SensorsforRestoration/SensorsForRestoration/updates/week5/forces.pdf

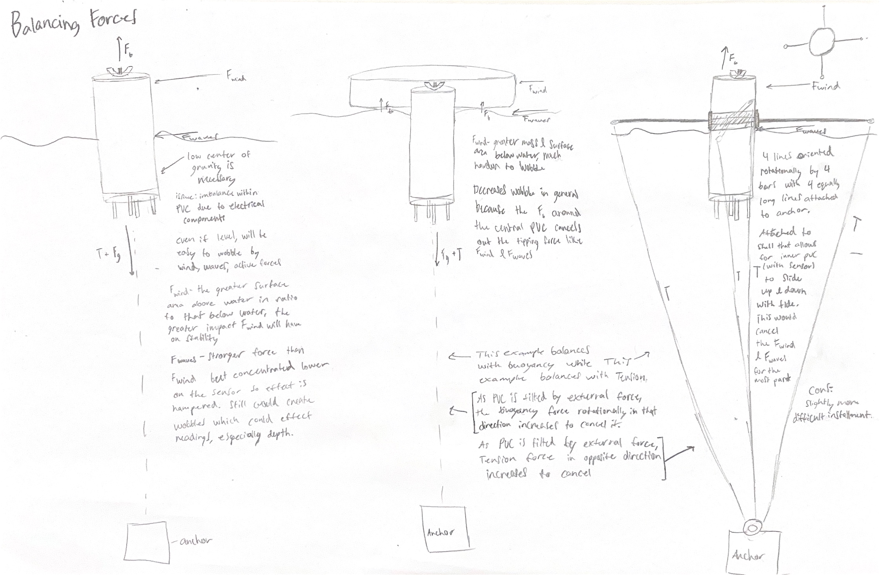
[picture p1: page 1]
