SensorsforRestoration/SensorsForRestoration/docs/tools/image2.png

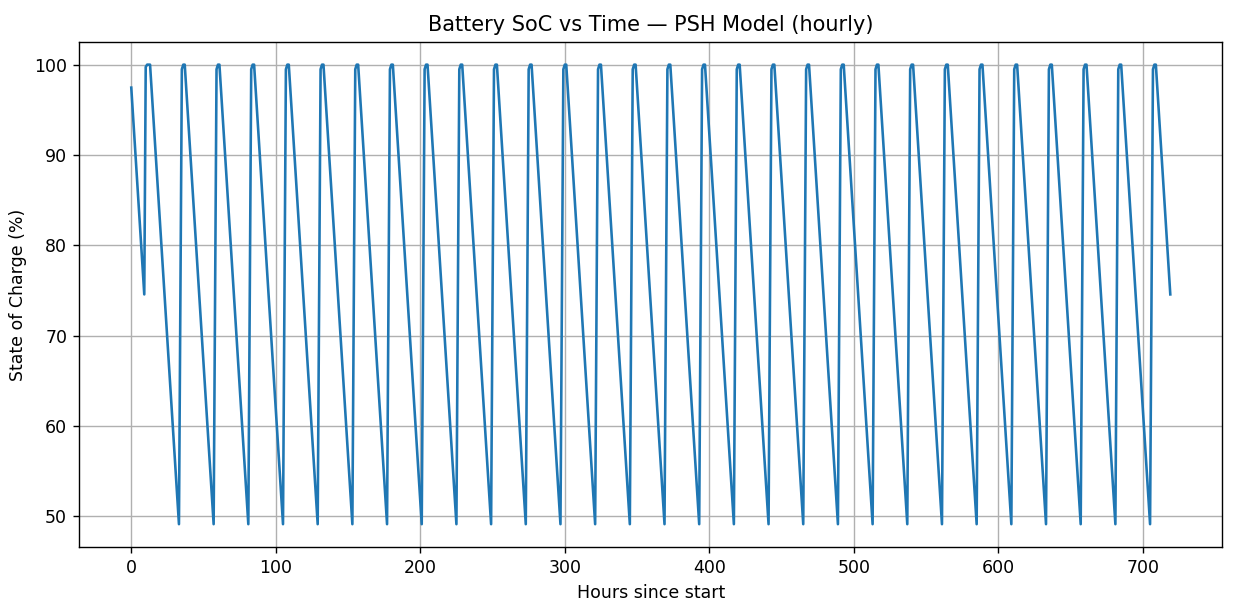
docs/tools/image2.png
