SensorsforRestoration/SensorsForRestoration/updates/week5/depth2.png

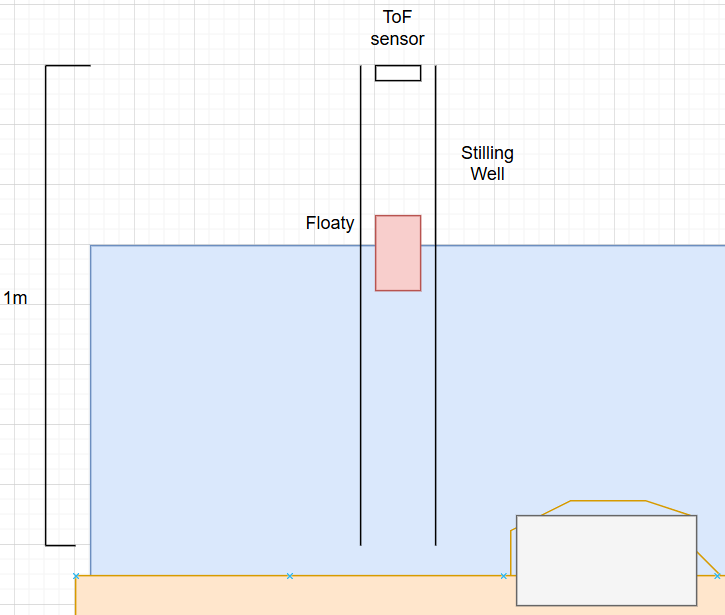
updates/week5/depth2.png
