SensorsforRestoration/SensorsForRestoration/updates/week5/explored_depth.png

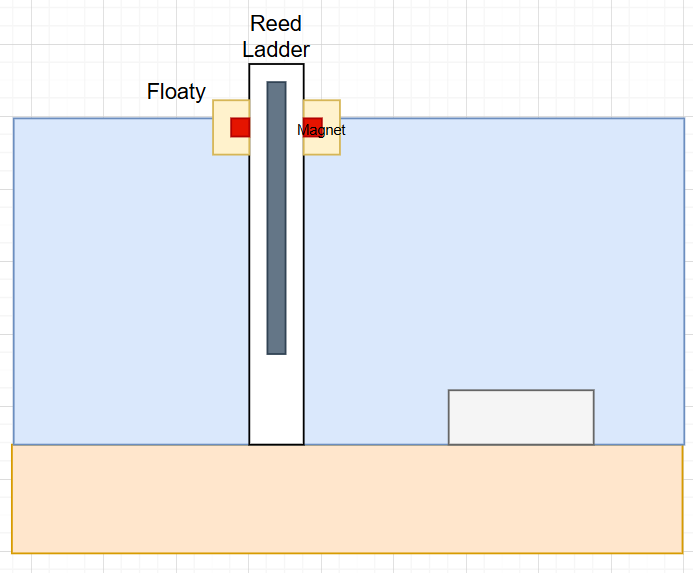
updates/week5/explored_depth.png
