SensorsforRestoration/SensorsForRestoration/updates/week6/friedSensor.jpeg

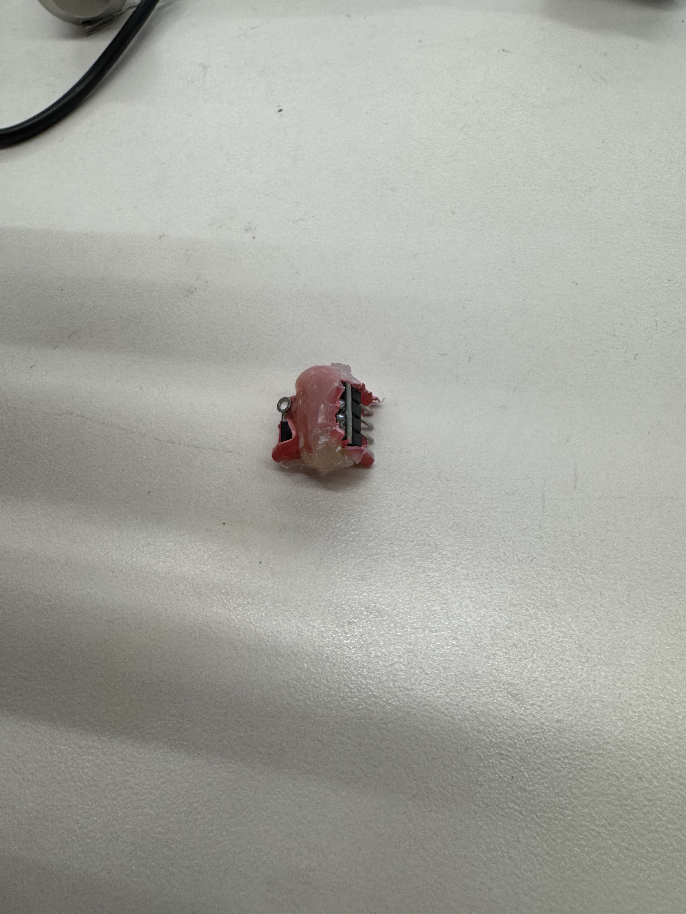
updates/week6/friedSensor.jpeg
