SensorsforRestoration/SensorsForRestoration/updates/week6/SubmergenceDepth.jpg

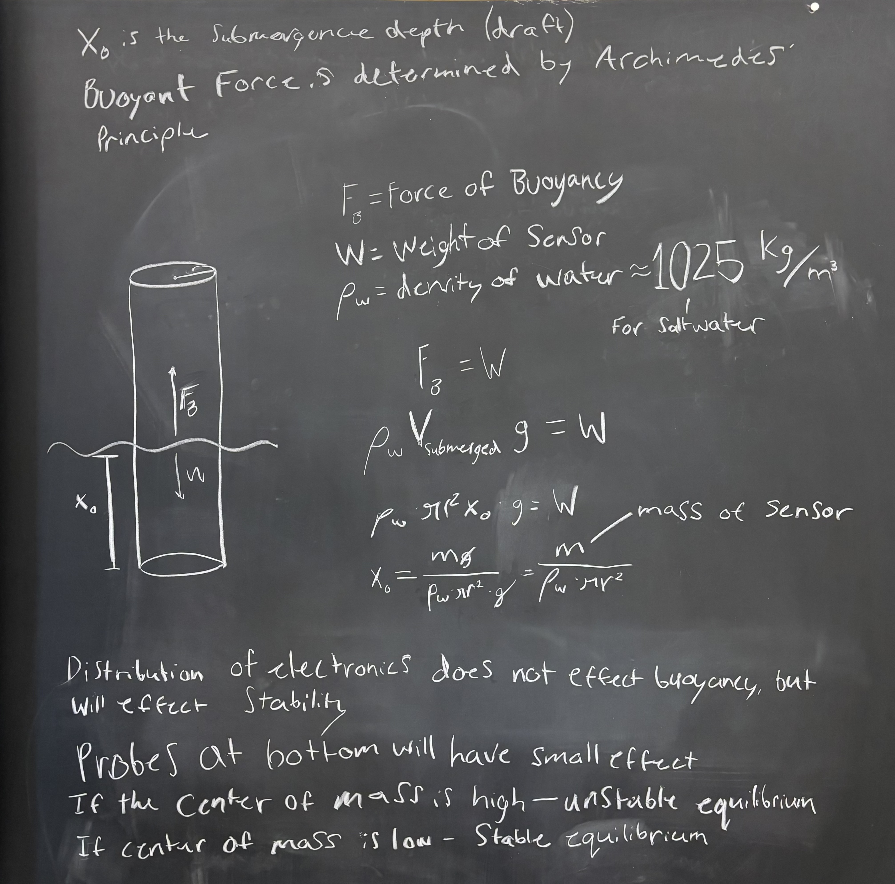
updates/week6/SubmergenceDepth.jpg
