SensorsforRestoration/SensorsForRestoration/updates/week7/Depth_with_biofowling.jpg

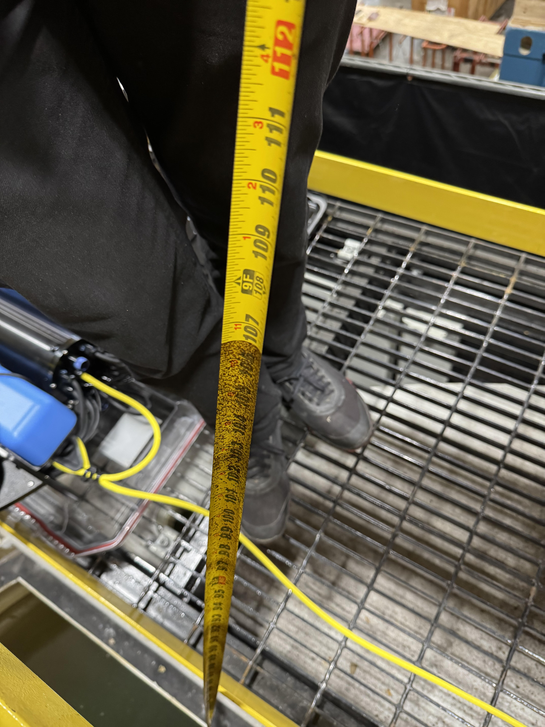
updates/week7/Depth_with_biofowling.jpg
