SensorsforRestoration/SensorsForRestoration/updates/week7/Fun_photo.jpg

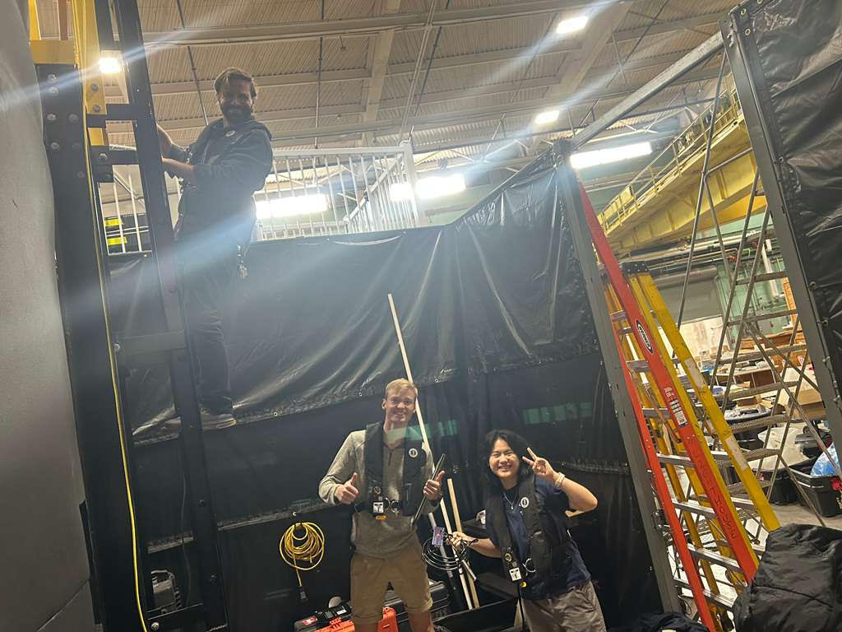
updates/week7/Fun_photo.jpg
