SensorsforRestoration/SensorsForRestoration/updates/week7/Graph1.png

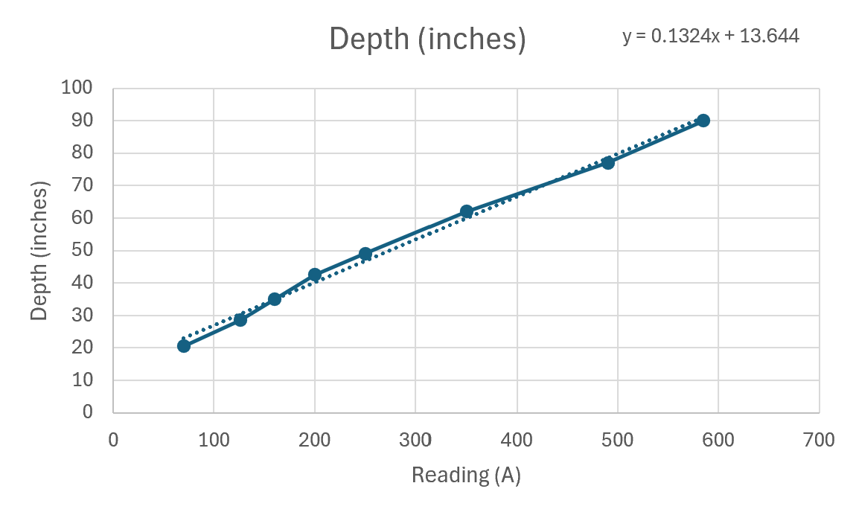
updates/week7/Graph1.png
