SensorsforRestoration/SensorsForRestoration/updates/week7/IMG_4251.jpg

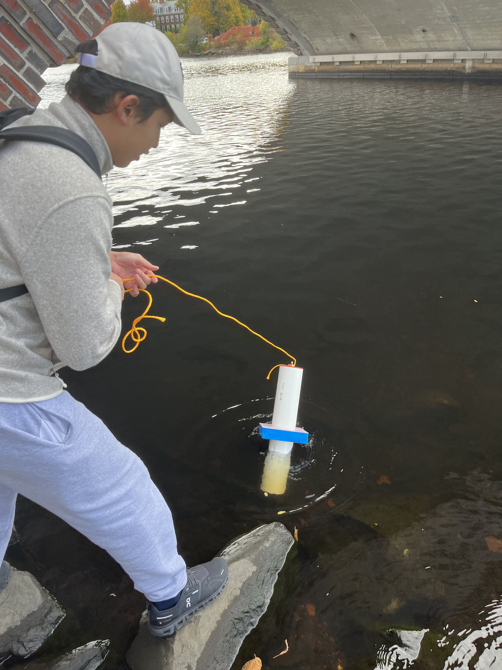
updates/week7/IMG_4251.jpg
