SensorsforRestoration/SensorsForRestoration/updates/week8/ColourCord.jpg

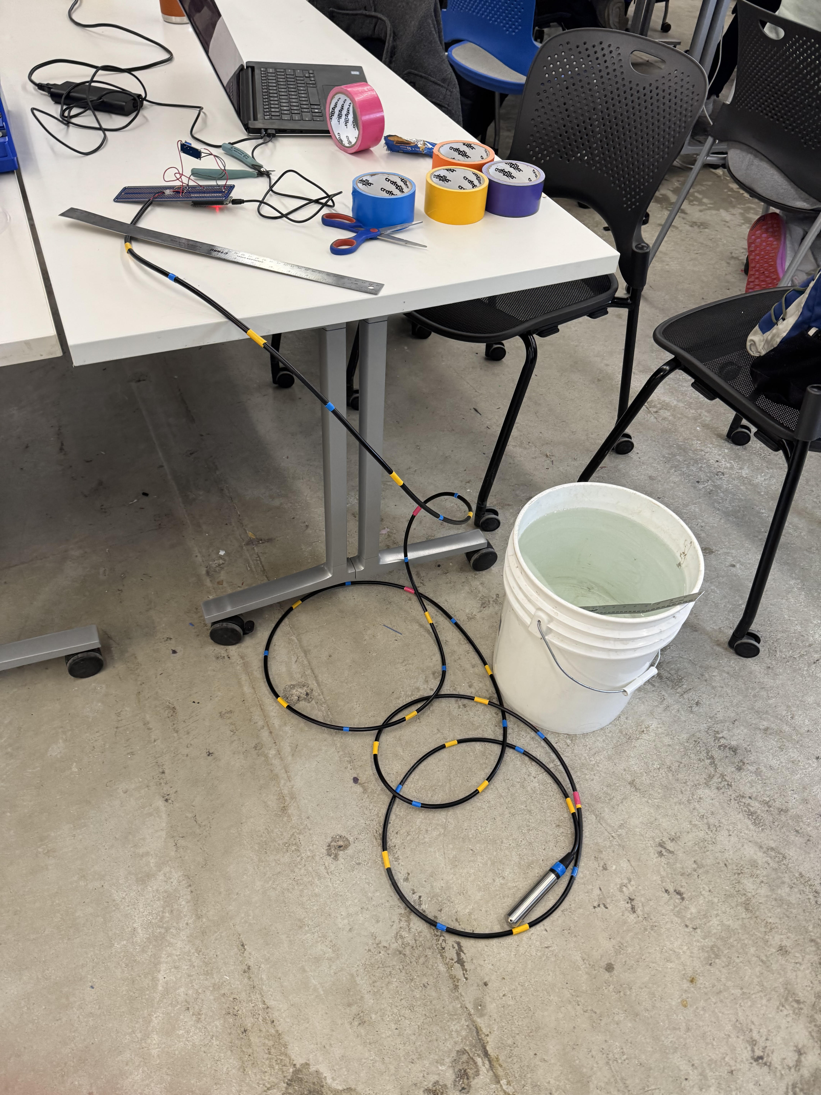
updates/week8/ColourCord.jpg
