SensorsforRestoration/SensorsForRestoration/updates/week8/Graph2.png

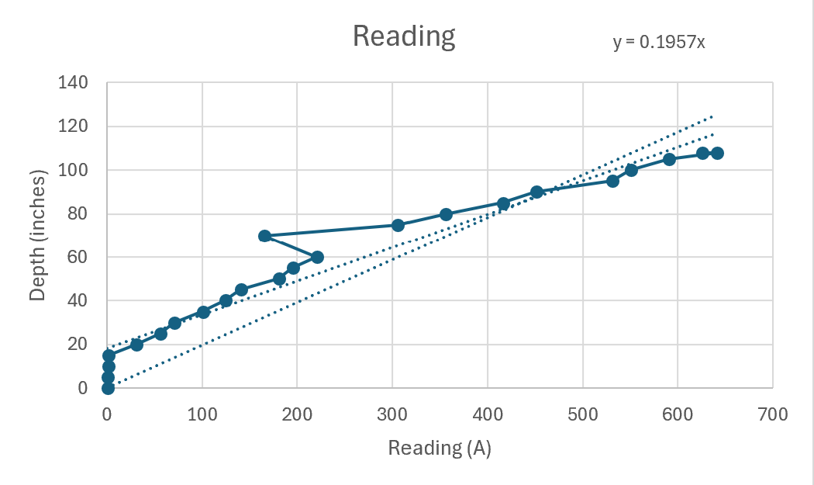
updates/week8/Graph2.png
