SensorsforRestoration/SensorsForRestoration/updates/week8/Table2.png

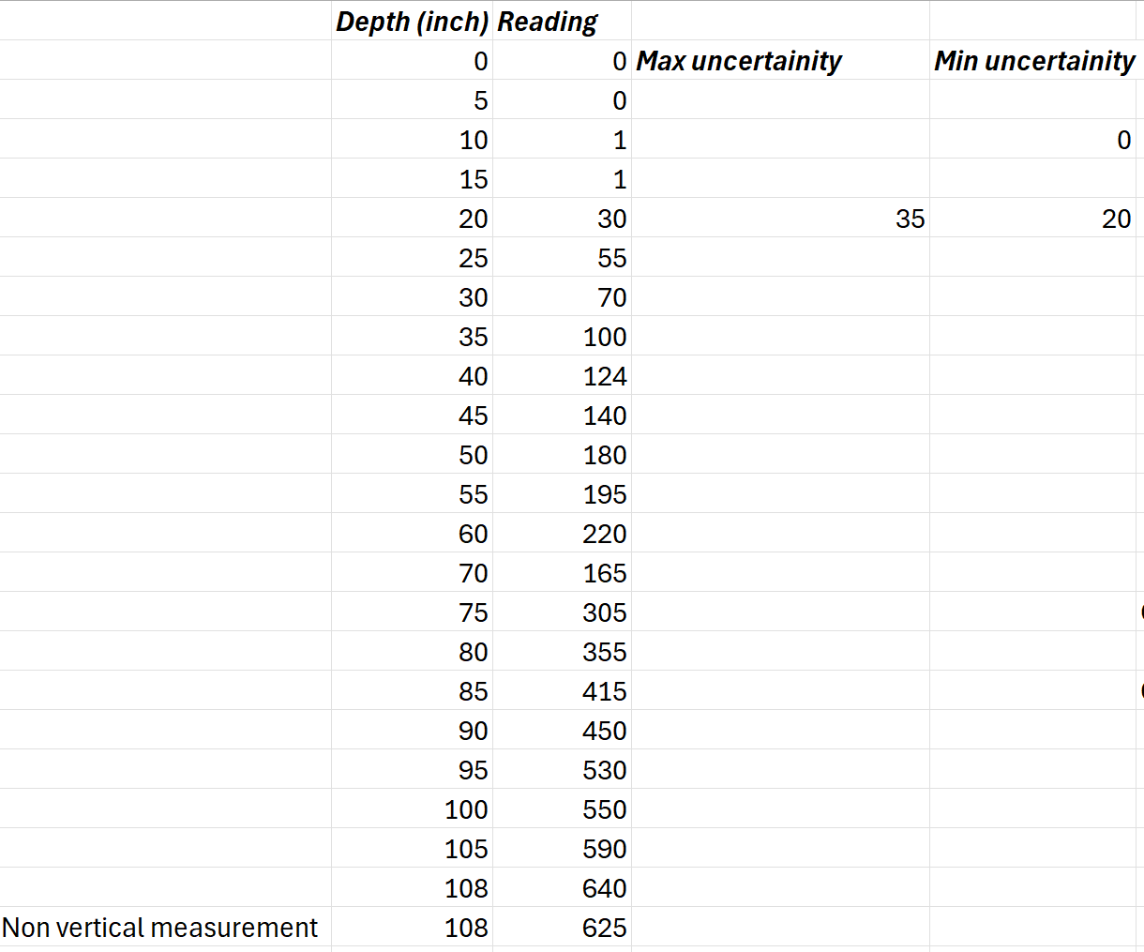
updates/week8/Table2.png
