SensorsforRestoration/SensorsForRestoration/updates/week9/Cad_picture2.png

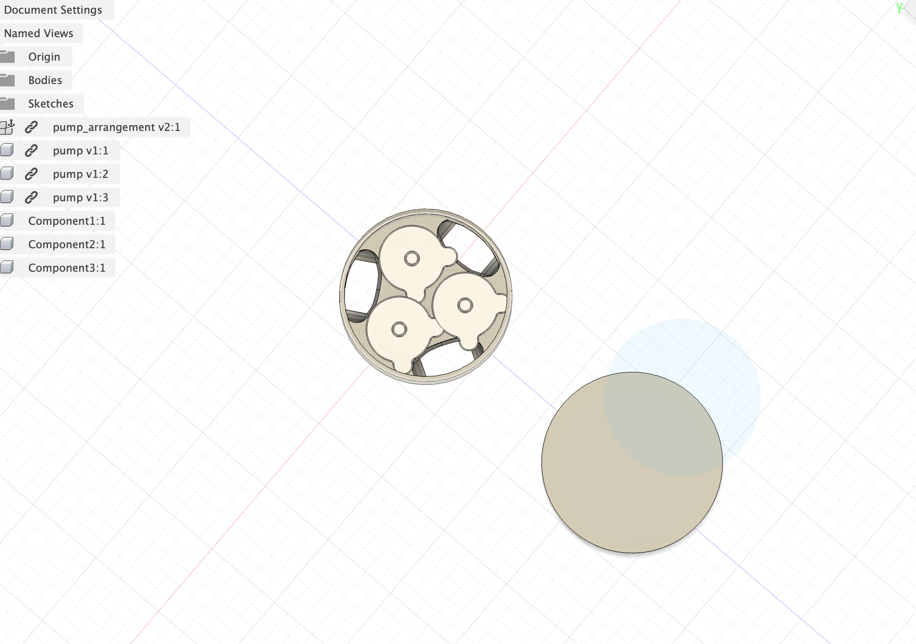
updates/week9/Cad_picture2.png
