SensorsforRestoration/SensorsForRestoration/updates/week9/Cad_picture.png

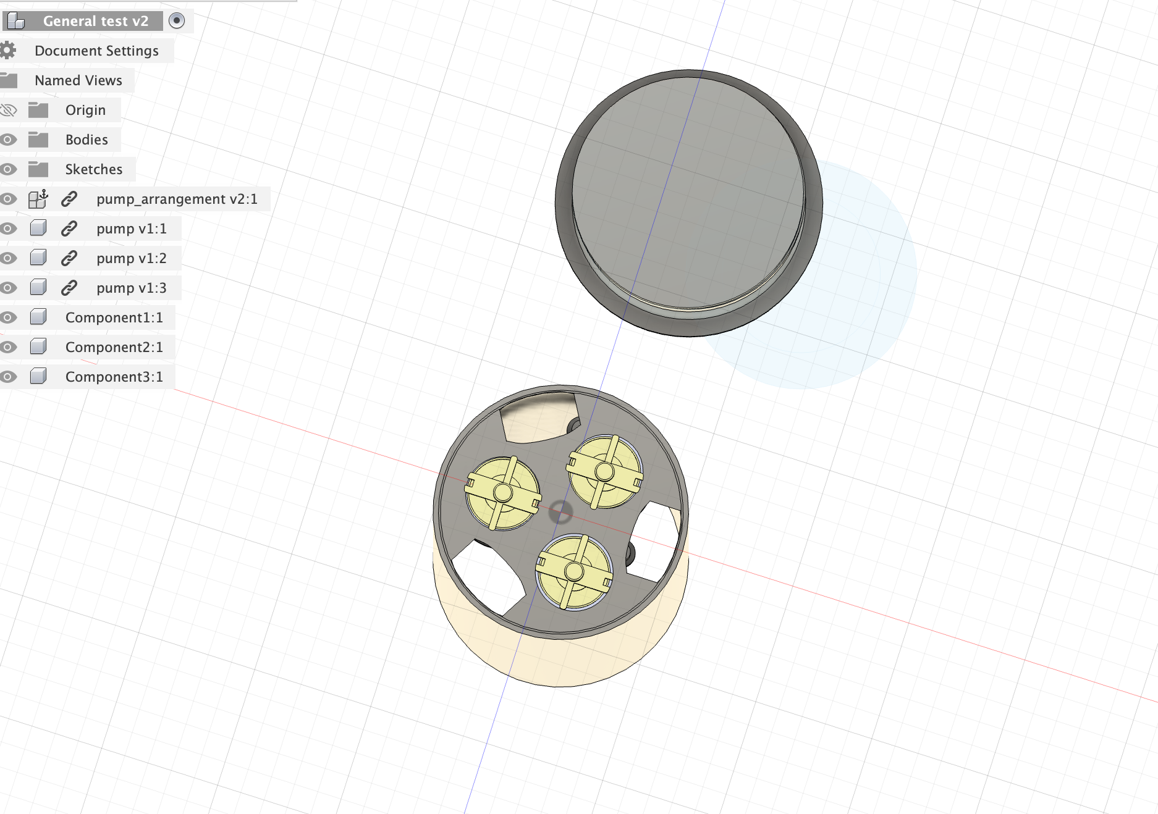
updates/week9/Cad_picture.png
