SensorsforRestoration/SensorsForRestoration/updates/week10/image2.png

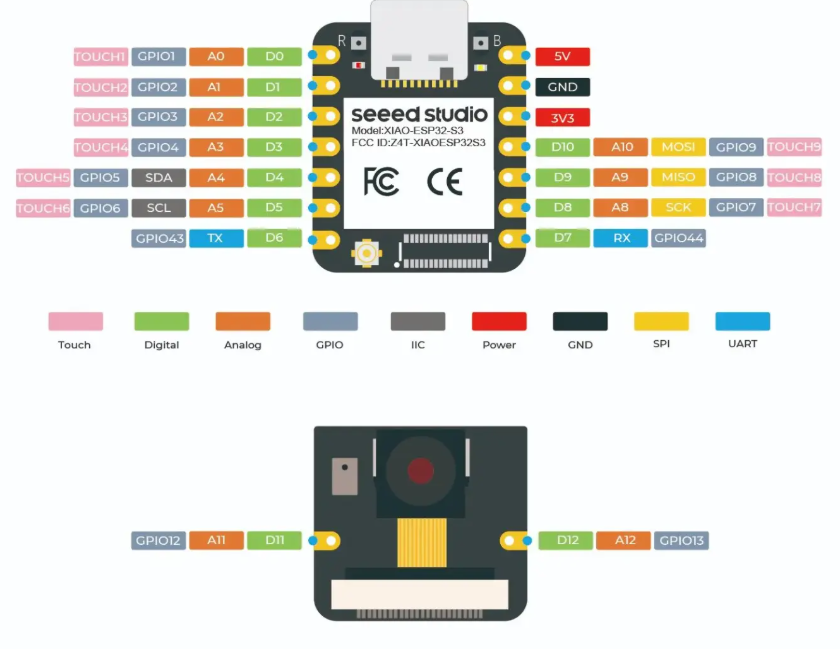
updates/week10/image2.png
