SensorsforRestoration/SensorsForRestoration/updates/week10/image.png

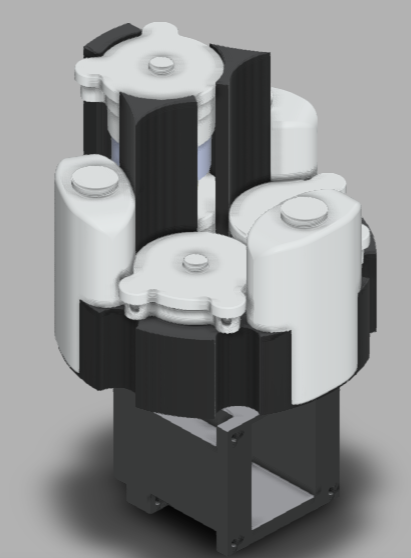
updates/week10/image.png
