SensorsforRestoration/SensorsForRestoration/updates/week10/IMG_4394.jpg

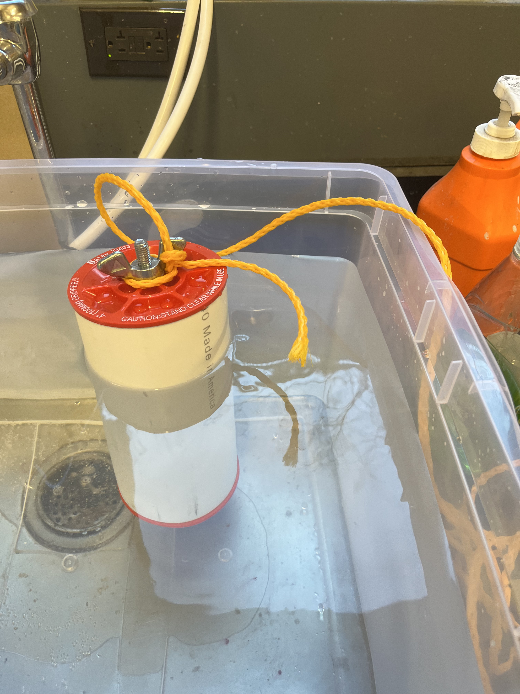
updates/week10/IMG_4394.jpg
