SensorsforRestoration/SensorsForRestoration/docs/build_instruction/BOM.md

(#) Bill of Materials (BOM)

Estimated prices and weights for the core parts used in the project. Prices are approximate (USD) and weights are in grams (g). Totals are rounded.

| Item | Qty | Unit price (USD) | Unit weight (g) | Ext. price (USD) | Ext. weight (g) |
|---|---:|---:|---:|---:|---:|
| 18650 Li-ion cell (protected/typical) | 1 | 6.00 | 48 | 6.00 | 48 |
| 18650 holder / protection (holder or small PCB) | 1 | 2.00 | 12 | 2.00 | 12 |
| Small DC / peristaltic pump (micro) | 4 | 6.50 | 70 | 26.00 | 280 |
| L9110 dual motor driver board | 2 | 2.00 | 15 | 4.00 | 30 |
| Seeed XIAO ESP32‑S3 Sense | 1 | 12.00 | 6 | 12.00 | 6 |
| Depth sensor (waterproof ultrasonic / JSN‑SR04T or similar) | 1 | 8.00 | 20 | 8.00 | 20 |
| Salinity sensor (analog conductivity probe + module) | 1 | 12.00 | 30 | 12.00 | 30 |
| Reactant A (reagent bottle) | 1 | 5.00 | 50 | 5.00 | 50 |
| Reactant B (reagent bottle) | 1 | 5.00 | 50 | 5.00 | 50 |
| Reactant C (reagent bottle) | 1 | 5.00 | 50 | 5.00 | 50 |
| Miscellaneous (wiring, connectors, screws, enclosure bits) | 1 | 10.00 | 80 | 10.00 | 80 |

| 4" PVC pipe (~35 cm length) | 1 | 6.00 | 500 | 6.00 | 500 |

| **Totals** |  |  |  | **101.00 USD** | **1,156 g** |

Notes

- Prices are ballpark estimates (consumer hobbyist retail) as of 2025‑11‑18 and will vary by supplier, quantity, shipping and taxes.
- Weights are approximate based on typical small parts; they exclude packaging and any large enclosures or extra batteries.
- Vendor‑linked BOM (Mouser/AliExpress/Adafruit) work in progress
