SensorsforRestoration/SensorsForRestoration/build/index.html

# Build

### Contents

© Sensors for Restoration
