SensorsforRestoration/SensorsForRestoration/updates/week5/20251410Test001.jpg

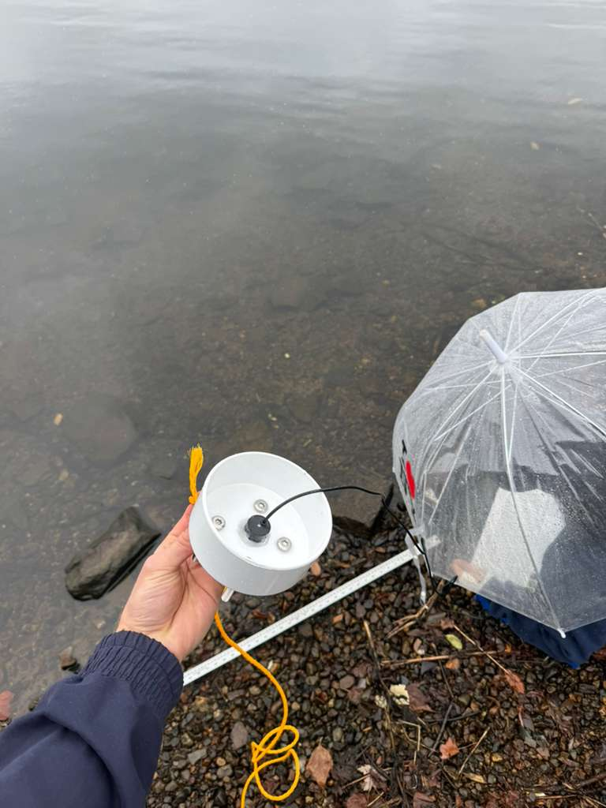
updates/week5/20251410Test001.jpg
