SensorsforRestoration/SensorsForRestoration/updates/week5/20251410Test002.jpg

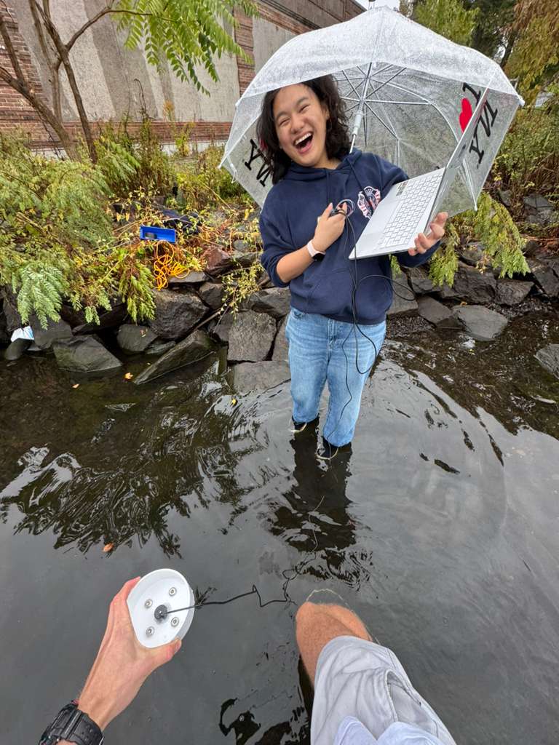
updates/week5/20251410Test002.jpg
