SensorsforRestoration/SensorsForRestoration/updates/week5/20251410Test003.jpg

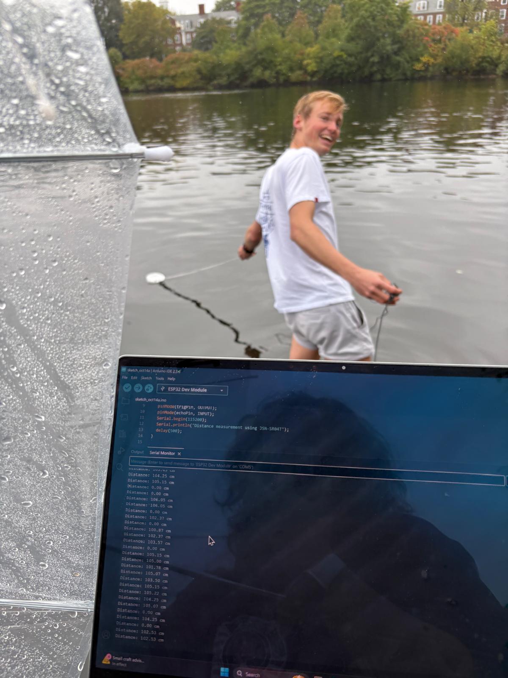
updates/week5/20251410Test003.jpg
