SensorsforRestoration/SensorsForRestoration/updates/week5/Nitrate_Test.jpg

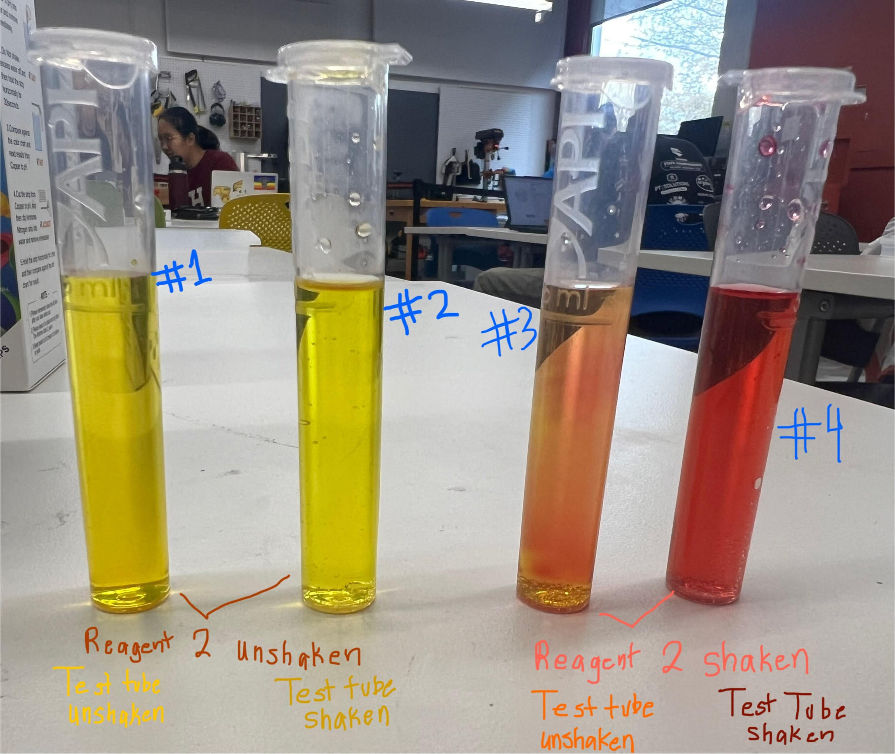
updates/week5/Nitrate_Test.jpg
