SensorsforRestoration/SensorsForRestoration/updates/week8/tests2.png

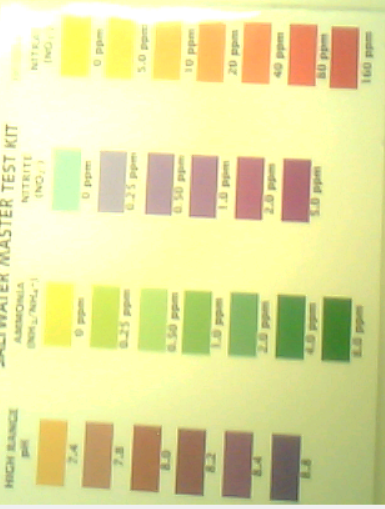
updates/week8/tests2.png
