SensorsforRestoration/SensorsForRestoration/updates/week8/tests.png

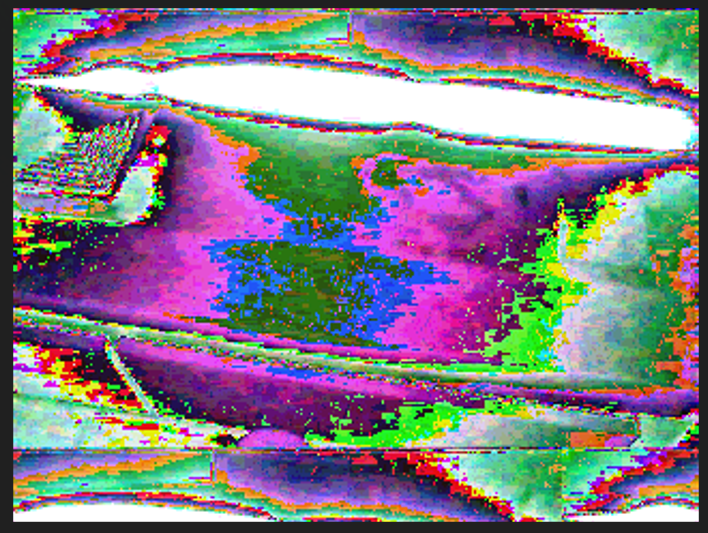
updates/week8/tests.png
