SensorsforRestoration/SensorsForRestoration/updates/week8/testsetup.png

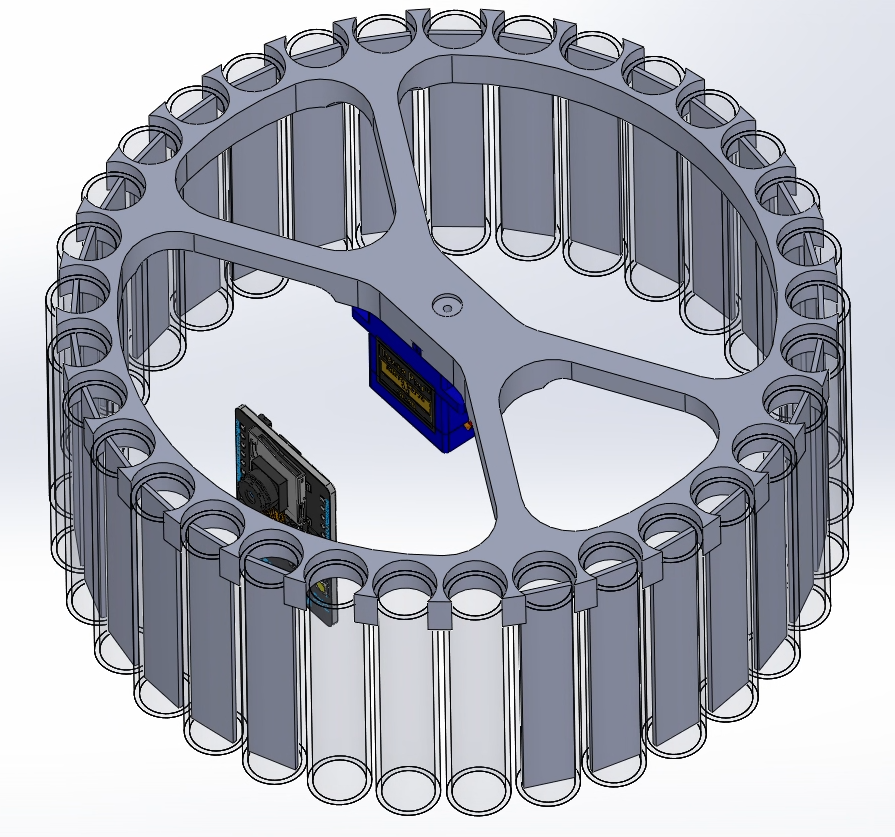
updates/week8/testsetup.png
