SensorsforRestoration/SensorsForRestoration/(commit log)

2025-10-07 Wrote the code for sending data on the arduino
2025-10-14 separate modes for sensor and receiver code
2025-10-16 ESP32 send period data and receive/decode data format
2025-10-21 Initial commit: added sensor and receiver code
2025-10-21 Created a folder to consolidate physics of sensor
2025-10-28 Created a function to sync the clock on the arduino in the sensor when it is sending data back to the receiver arduino
2025-10-28 Add Air JSN Depth Sensor code
    Initial implementation of Air JSN Depth Sensor code with distance measurement functionality. Includes commented-out sections for WiFi and web server setup.
2025-11-04 Added update for housing team
2025-11-11 Rename Air JSN Depth Sensor Code to *OLD* Air JSN Depth Sensor Code
2025-11-11 V1 Superior Depth Sensor Code
2025-11-14 Added CAD pictures of the whole sensor
2025-11-18 fix packet file writing
    [storage.c]
2025-11-18 start of docs; added pin table
2025-11-18 pinout of seeed Studio XIAO ESP32-S3 Sense
2025-11-18 added battery calculator script into docs
2025-11-18 added bom with weight and price estimates
2025-11-18 camera colormetric debug setup
2025-11-18 cad images
2025-12-01 Update index.html with new electronics section
    Added section on Electronics Water Depth and Arduino adaptation.
2025-12-01 Added Sensor image
2025-12-01 formatting worked; now uploading sensor code
2025-12-01 changed formatting language to cpp for arduino
2025-12-01 Add header for DYP-L04 Ultrasonic Sensor UART code
2025-12-22 Render build markdown client-side with marked (strapdown)
2025-12-22 Build: build hierarchical TOC by file; use marked CDN to avoid strapdown DOM replacement
2025-12-22 Build: fix TOC generation — group rendered headings under H1 and ensure unique IDs
2025-12-22 Build: use local strapdown.js parser by default to avoid CDN issues
2025-12-22 Build: ensure strapdown renders in-place; remove code fences from markdown
2025-12-22 Build: fallback to marked rendering if strapdown didn't parse markdown
2025-12-22 Build: use local strapdown.js; wait for div#content and build TOC
2025-12-22 Build: remove code-fence wrappers from BOM and pin_table so Strapdown can parse
2025-12-22 strapdown: avoid injecting missing theme/css; replace markdown via parentNode; add inline favicon
2026-01-01 Wrote function for sensor to short-term store data for depth sensing and RGB measurements from the camera
    [partitions.csv]
2026-01-20 Debugged the sensor code
    [partitions.csv]
2026-01-20 sensor side timesync
2026-01-23 High Level Electronics Schematic
2026-01-23 Rename V1 Overall Electronics Schematic.png to overall_schematic
2026-01-23 Fix heading case and add overall schematic image
    Corrected heading capitalization and added a new image for the overall schematic.
2026-01-23 Update pin_table.html with power improvement notes
    Added improvement notes regarding power requirements.
2026-01-23 Update ESP32 description with link and details
