SensorsforRestoration/SensorsForRestoration/updates/week7/CircuitPressure.jpeg

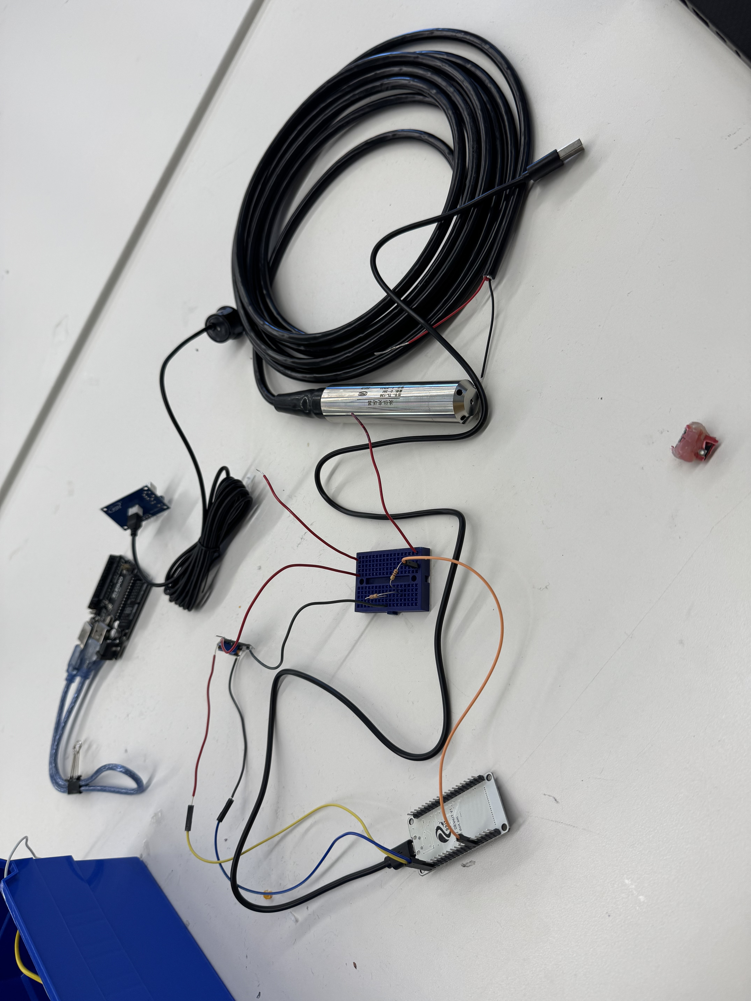
updates/week7/CircuitPressure.jpeg
