SensorsforRestoration/SensorsForRestoration/updates/week10/IMG_2702.JPG

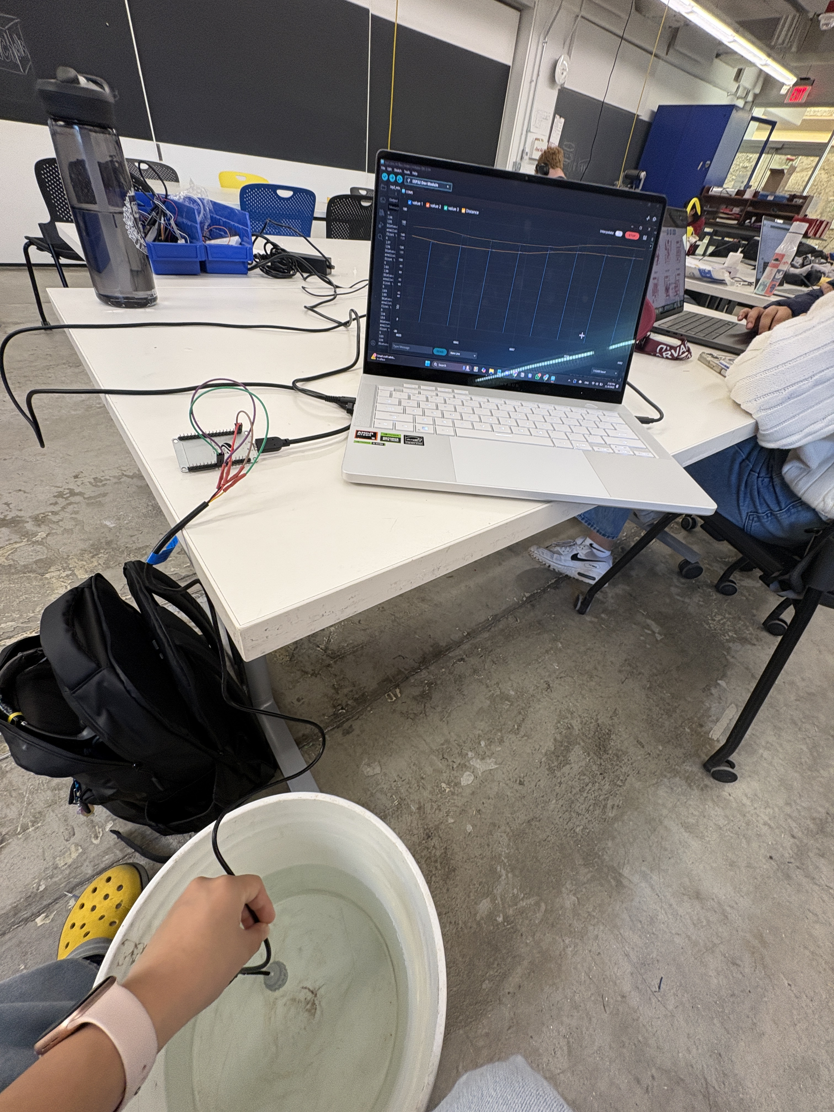
updates/week10/IMG_2702.JPG
